HeCoding180/RPiSelectaShield/Hardware/Selecta Pi Shield V1_1.brd

## EAGLE design Hardware/Selecta Pi Shield V1_1.brd (2022-07-05)

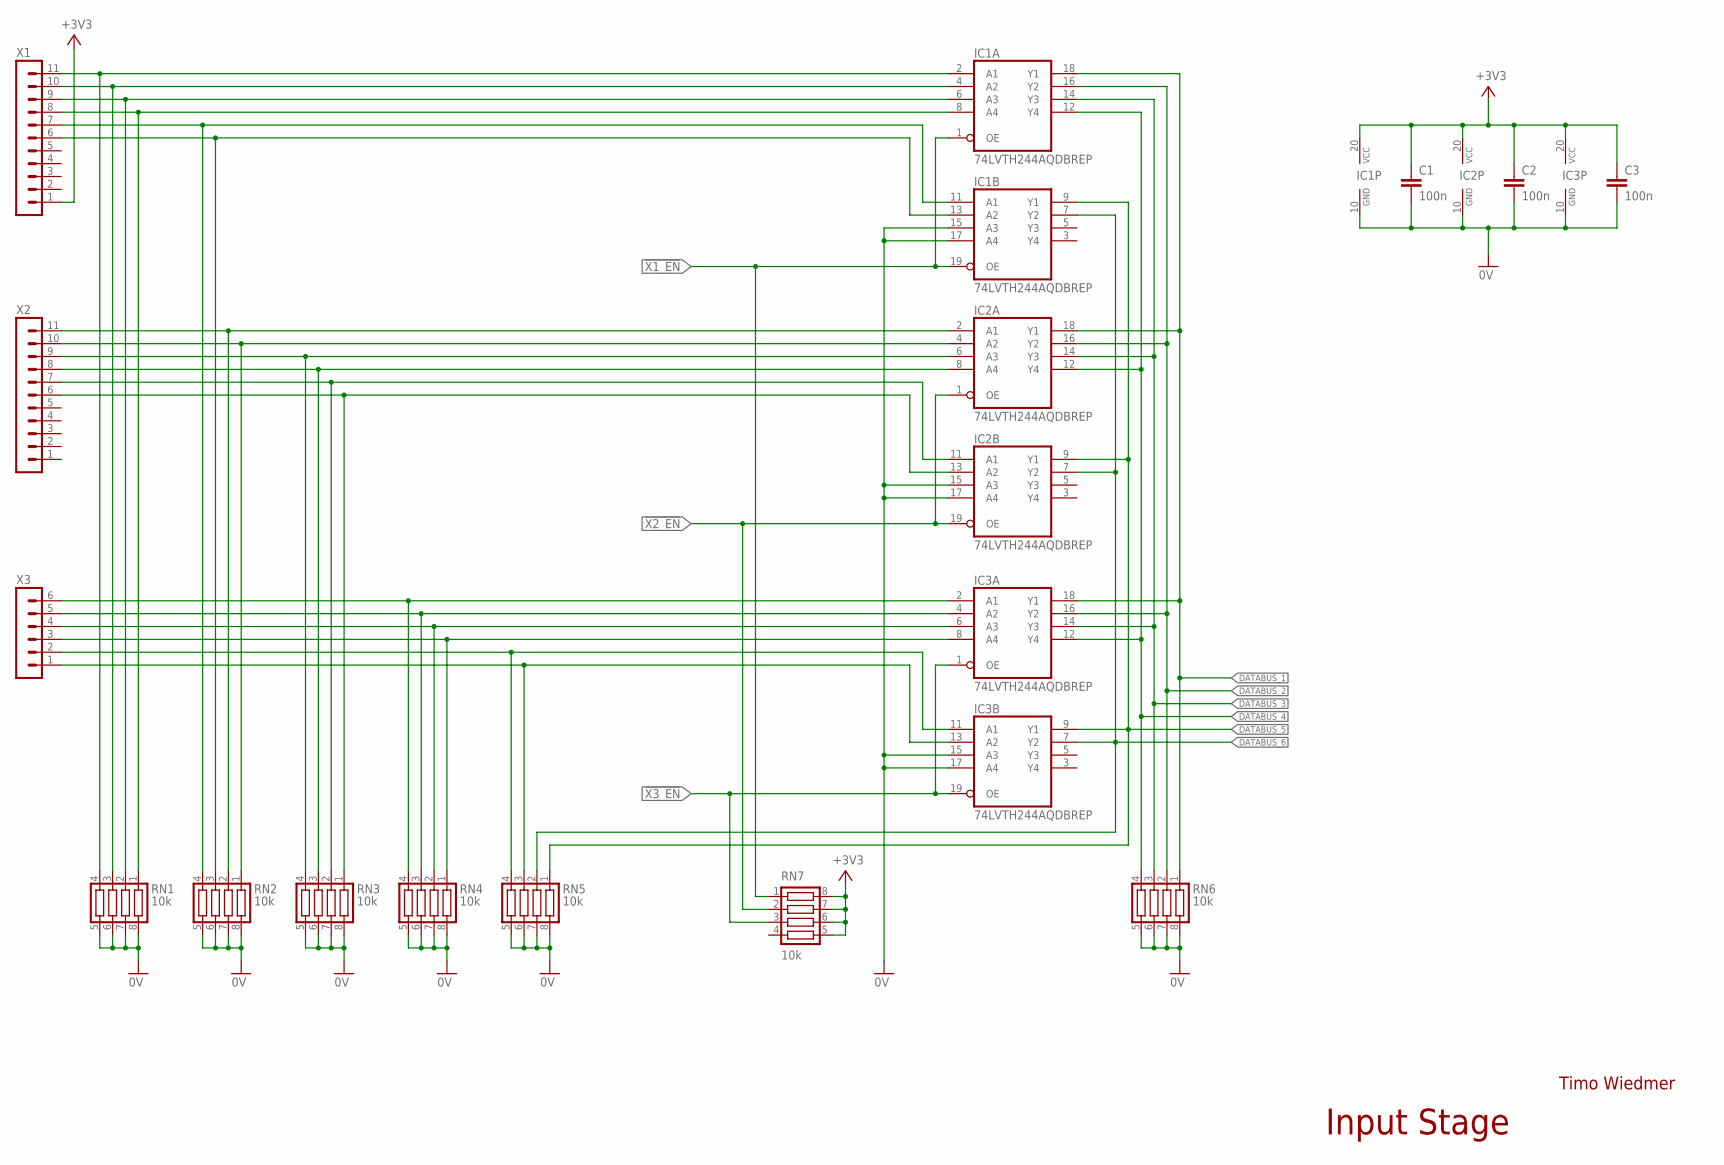
[picture p2: schematic Selecta Pi Shield V1_1.sch, sheet 1]

Parts:
C1, C2, C3: 100n; C0603
IC1, IC2, IC3: 74LVTH244AQDBREP; SSOP20
RN1, RN2, RN3, RN4, RN5, RN6, RN7: 10k; CTS742C083
X1, X2: MA11-1
X3: MA06-1

Connections:
0V: C1.2, C2.2, C3.2, IC1.10 (GND), IC1.15 (A3), IC1.17 (A4), IC2.10 (GND), IC2.15 (A3), IC2.17 (A4), IC3.10 (GND), IC3.15 (A3), IC3.17 (A4), RN1.5, RN1.6, RN1.7, RN1.8, RN2.5, RN2.6, RN2.7, RN2.8, RN3.5, RN3.6, RN3.7, RN3.8, RN4.5, RN4.6, RN4.7, RN4.8, RN5.5, RN5.6, RN5.7, RN5.8, RN6.5, RN6.6, RN6.7, RN6.8; also elsewhere on the board
!X1_EN: IC1.1 (OE), IC1.19 (OE), RN7.1; also elsewhere on the board
!X2_EN: IC2.1 (OE), IC2.19 (OE), RN7.2; also elsewhere on the board
!X3_EN: IC3.1 (OE), IC3.19 (OE), RN7.3; also elsewhere on the board
+3V3: C1.1, C2.1, C3.1, IC1.20 (VCC), IC2.20 (VCC), IC3.20 (VCC), RN7.5, RN7.6, RN7.7, RN7.8, X1.1; also elsewhere on the board
B_SELECT1: IC3.2 (A1), RN4.4, X3.6
B_SELECT2: IC3.4 (A2), RN4.3, X3.5
B_SELECT3: IC3.6 (A3), RN4.2, X3.4
B_SELECT4: IC3.8 (A4), RN4.1, X3.3
B_SELECT5: IC3.11 (A1), RN5.4, X3.2
B_SELECT6: IC3.13 (A2), RN5.3, X3.1
DATABUS_1: IC1.18 (Y1), IC2.18 (Y1), IC3.18 (Y1), RN6.1; also elsewhere on the board
DATABUS_2: IC1.16 (Y2), IC2.16 (Y2), IC3.16 (Y2), RN6.2; also elsewhere on the board
DATABUS_3: IC1.14 (Y3), IC2.14 (Y3), IC3.14 (Y3), RN6.3; also elsewhere on the board
DATABUS_4: IC1.12 (Y4), IC2.12 (Y4), IC3.12 (Y4), RN6.4; also elsewhere on the board
DATABUS_5: IC1.9 (Y1), IC2.9 (Y1), IC3.9 (Y1), RN5.1; also elsewhere on the board
DATABUS_6: IC1.7 (Y2), IC2.7 (Y2), IC3.7 (Y2), RN5.2; also elsewhere on the board
unnamed: IC1.2 (A1), RN1.4, X1.11
unnamed: IC1.4 (A2), RN1.3, X1.10
unnamed: IC1.6 (A3), RN1.2, X1.9
unnamed: IC1.8 (A4), RN1.1, X1.8
unnamed: IC2.2 (A1), RN2.2, X2.11
unnamed: IC2.4 (A2), RN2.1, X2.10
unnamed: IC2.6 (A3), RN3.4, X2.9
unnamed: IC2.8 (A4), RN3.3, X2.8
unnamed: IC1.11 (A1), RN2.4, X1.7
unnamed: IC1.13 (A2), RN2.3, X1.6
unnamed: IC2.11 (A1), RN3.2, X2.7
unnamed: IC2.13 (A2), RN3.1, X2.6

Notes on the sheet:
Timo Wiedmer
Input Stage

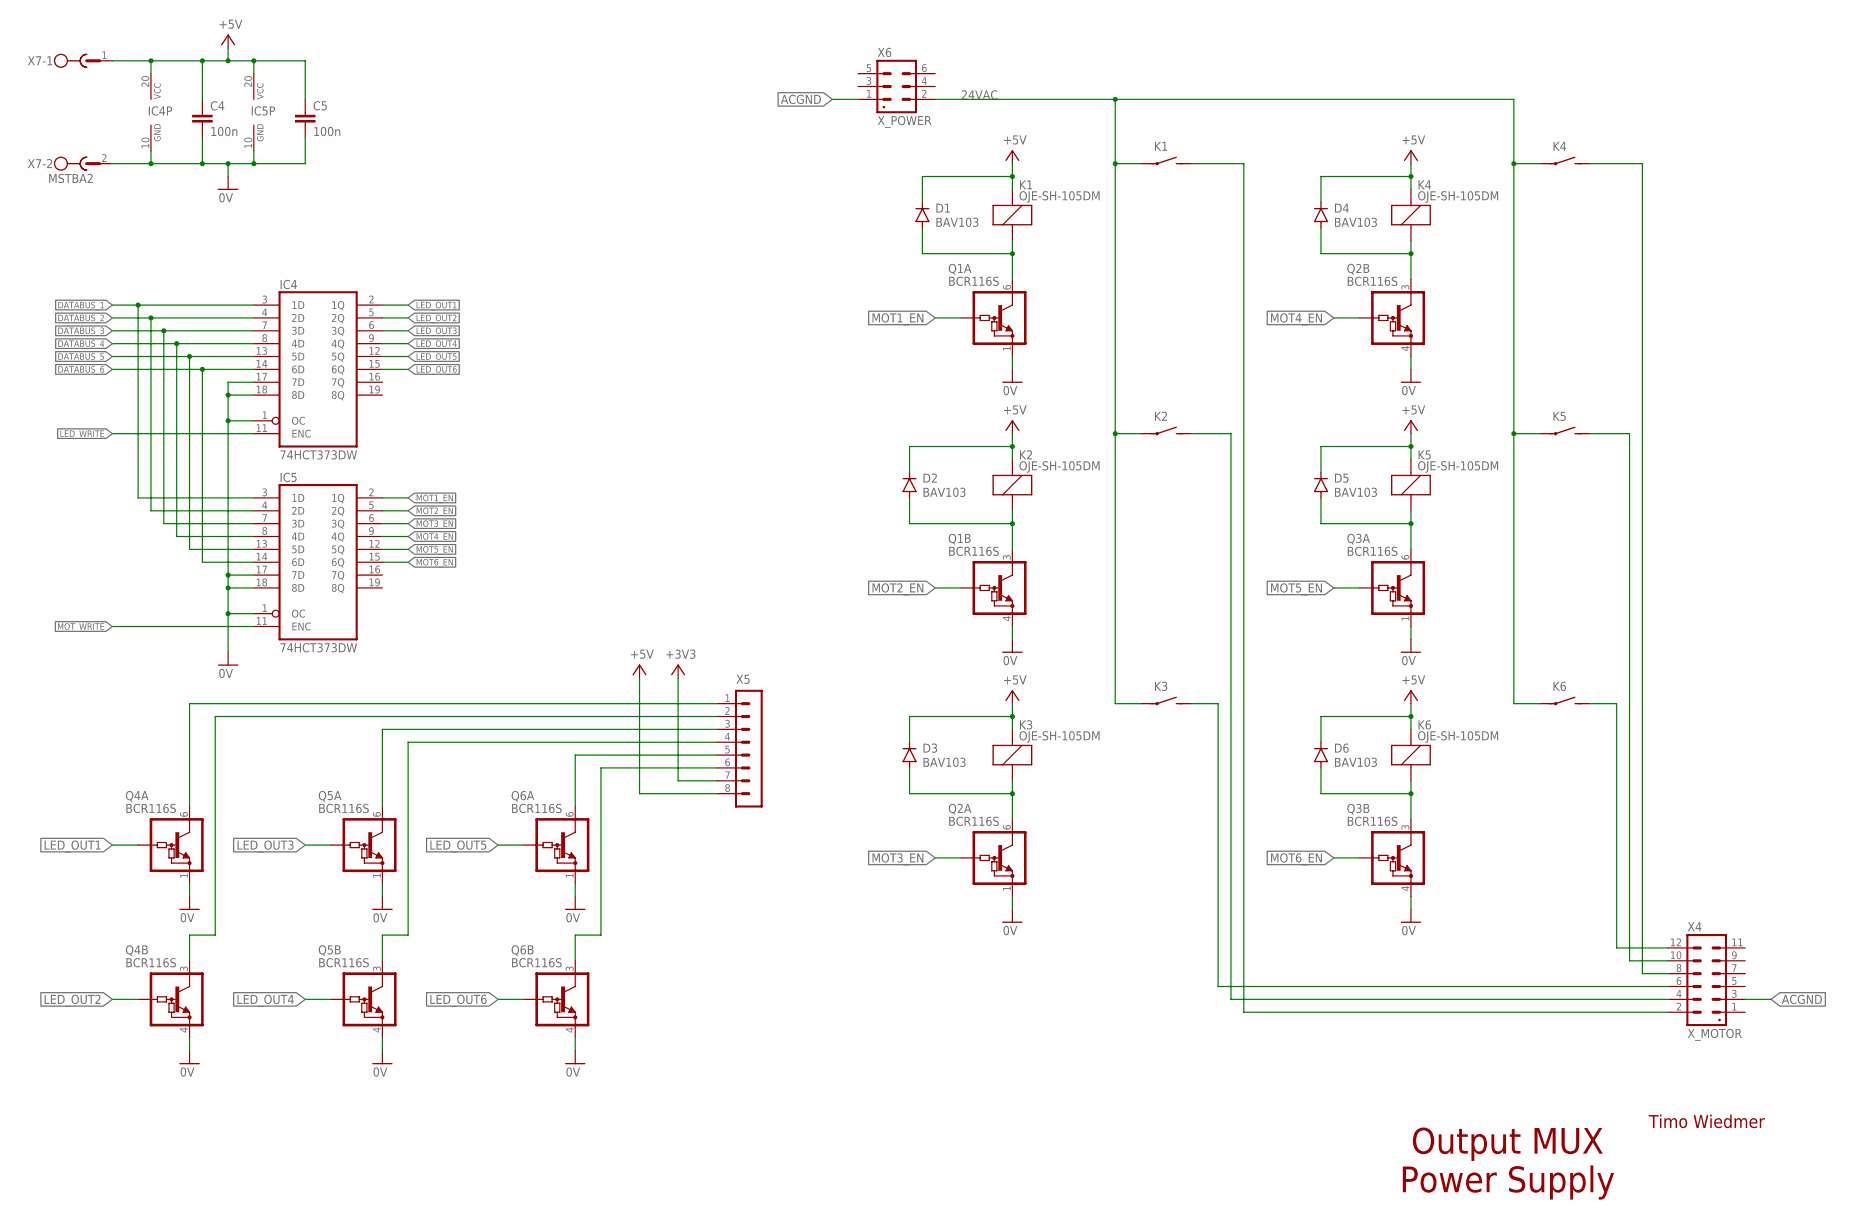
[picture p3: schematic Selecta Pi Shield V1_1.sch, sheet 2]

Parts:
C4, C5: 100n; C0603
D1, D2, D3, D4, D5, D6: BAV103; SOD-123_MINI-SMA
IC4, IC5: 74HCT373DW; SO20W
K1, K2, K3, K4, K5, K6: OJE-SH-105DM
Q1, Q2, Q3, Q4, Q5, Q6: BCR116S; SOT363
X4: X_MOTOR; 12P_MINI_FIT
X5: MA08-1
X6: X_POWER; 6P_MINI_FIT
X7: MSTBA2

Connections:
0V: C4.2, C5.2, IC4.1 (OC), IC4.10 (GND), IC4.17 (7D), IC4.18 (8D), IC5.1 (OC), IC5.10 (GND), IC5.17 (7D), IC5.18 (8D), Q1.1 (E), Q1.4 (E), Q2.1 (E), Q2.4 (E), Q3.1 (E), Q3.4 (E), Q4.1 (E), Q4.4 (E), Q5.1 (E), Q5.4 (E), Q6.1 (E), Q6.4 (E), X7.2; also elsewhere on the board
24VAC: K1.COM, K2.COM, K3.COM, K4.COM, K5.COM, K6.COM, X6.2
24VAC_MOT1: K1.NO, X4.2
24VAC_MOT2: K2.NO, X4.4
24VAC_MOT3: K3.NO, X4.6
24VAC_MOT4: K4.NO, X4.8
24VAC_MOT5: K5.NO, X4.10
24VAC_MOT6: K6.NO, X4.12
+3V3: X5.7; also elsewhere on the board
+5V: C4.1, C5.1, D1.C, D2.C, D3.C, D4.C, D5.C, D6.C, IC4.20 (VCC), IC5.20 (VCC), K1.COILA (1), K2.COILA (1), K3.COILA (1), K4.COILA (1), K5.COILA (1), K6.COILA (1), X5.8, X7.1; also elsewhere on the board
ACGND: X4.3, X6.1
DATABUS_1: IC4.3 (1D), IC5.3 (1D); also elsewhere on the board
DATABUS_2: IC4.4 (2D), IC5.4 (2D); also elsewhere on the board
DATABUS_3: IC4.7 (3D), IC5.7 (3D); also elsewhere on the board
DATABUS_4: IC4.8 (4D), IC5.8 (4D); also elsewhere on the board
DATABUS_5: IC4.13 (5D), IC5.13 (5D); also elsewhere on the board
DATABUS_6: IC4.14 (6D), IC5.14 (6D); also elsewhere on the board
LED1: Q4.6 (C), X5.1
LED2: Q4.3 (C), X5.2
LED3: Q5.6 (C), X5.3
LED4: Q5.3 (C), X5.4
LED5: Q6.6 (C), X5.5
LED6: Q6.3 (C), X5.6
LED_OUT1: IC4.2 (1Q), Q4.2 (B)
LED_OUT2: IC4.5 (2Q), Q4.5 (B)
LED_OUT3: IC4.6 (3Q), Q5.2 (B)
LED_OUT4: IC4.9 (4Q), Q5.5 (B)
LED_OUT5: IC4.12 (5Q), Q6.2 (B)
LED_OUT6: IC4.15 (6Q), Q6.5 (B)
LED_WRITE: IC4.11 (ENC); also elsewhere on the board
MOT1_EN: IC5.2 (1Q), Q1.2 (B)
MOT2_EN: IC5.5 (2Q), Q1.5 (B)
MOT3_EN: IC5.6 (3Q), Q2.2 (B)
MOT4_EN: IC5.9 (4Q), Q2.5 (B)
MOT5_EN: IC5.12 (5Q), Q3.2 (B)
MOT6_EN: IC5.15 (6Q), Q3.5 (B)
MOT_WRITE: IC5.11 (ENC); also elsewhere on the board
unnamed: D3.A, K3.COILB (2), Q2.6 (C)
unnamed: D6.A, K6.COILB (2), Q3.3 (C)
unnamed: D5.A, K5.COILB (2), Q3.6 (C)
unnamed: D2.A, K2.COILB (2), Q1.3 (C)
unnamed: D1.A, K1.COILB (2), Q1.6 (C)
unnamed: D4.A, K4.COILB (2), Q2.3 (C)

Notes on the sheet:
Timo Wiedmer
Output MUX Power Supply

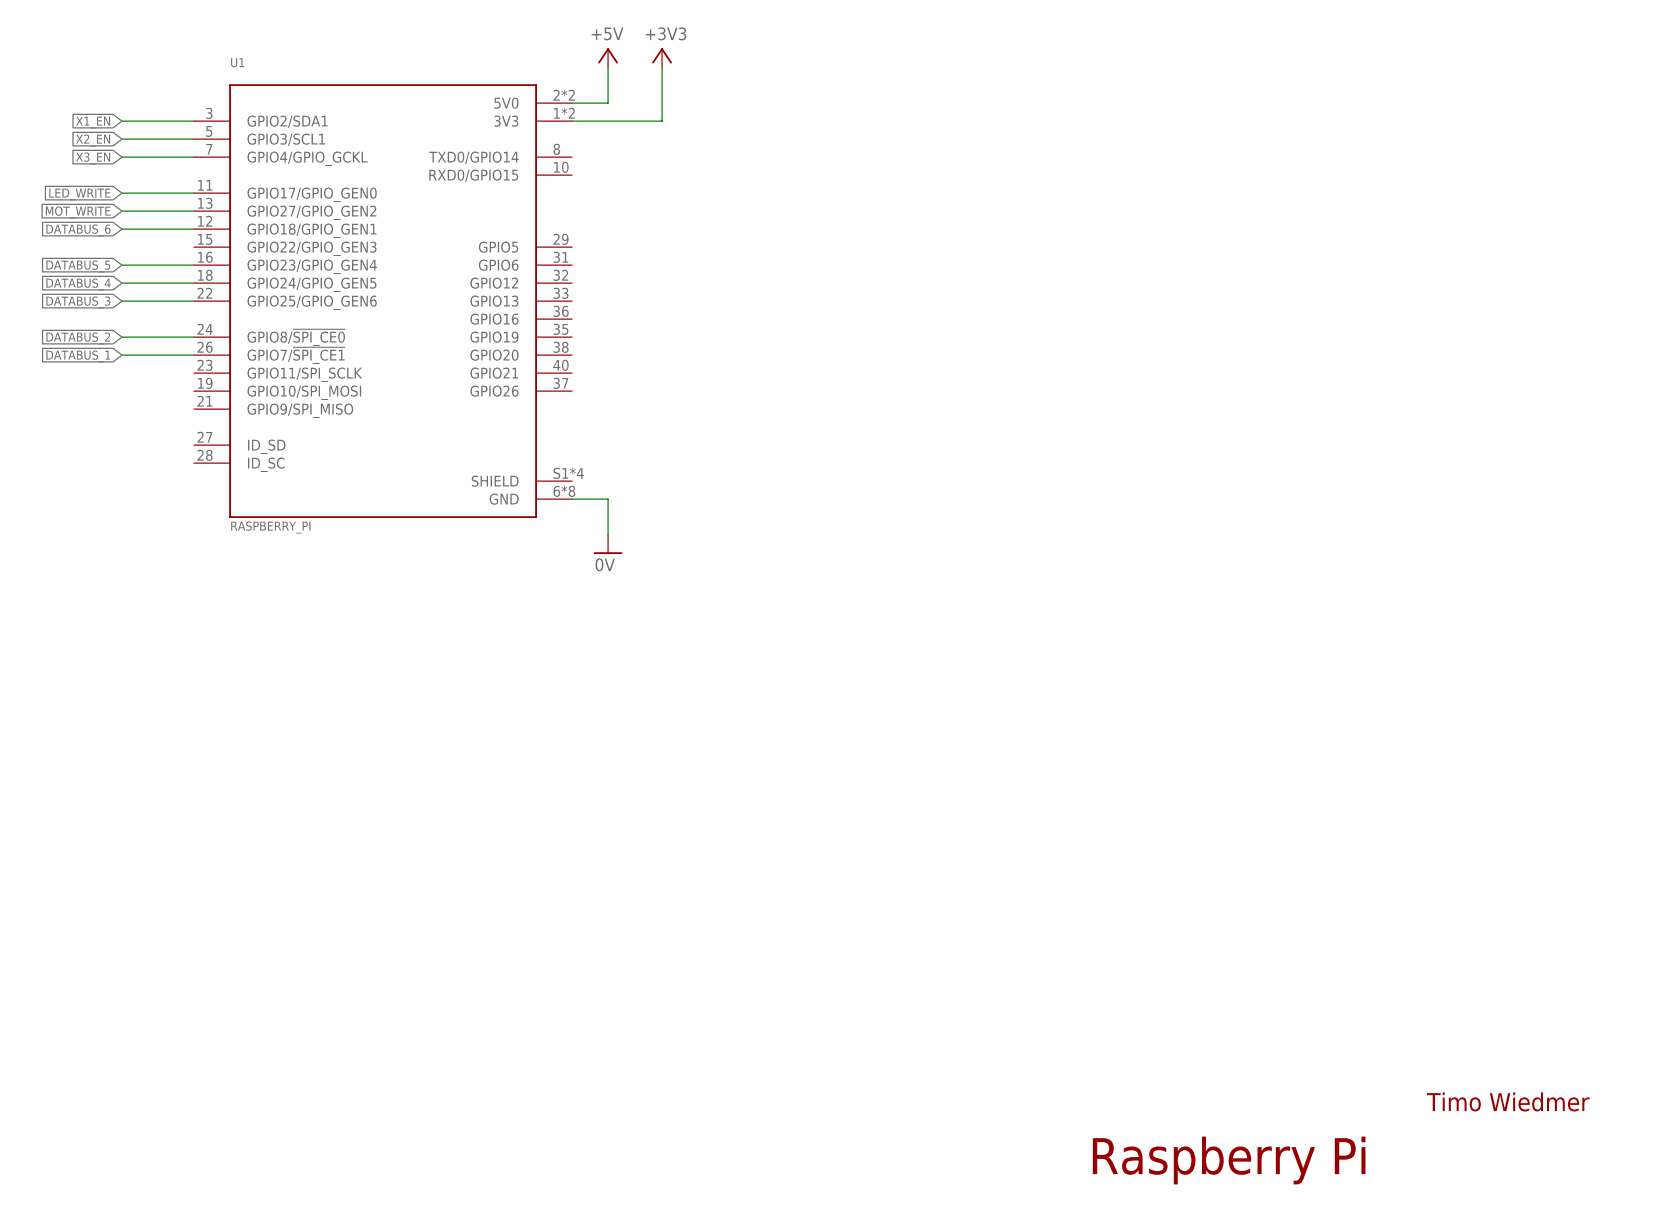
[picture p4: schematic Selecta Pi Shield V1_1.sch, sheet 3]

Parts:
U1: RASPBERRY_PI

Connections:
0V: U1.6 (GND), U1.9 (GND), U1.14 (GND), U1.20 (GND), U1.25 (GND), U1.30 (GND), U1.34 (GND), U1.39 (GND); also elsewhere on the board
!X1_EN: U1.3 (GPIO2/SDA1); also elsewhere on the board
!X2_EN: U1.5 (GPIO3/SCL1); also elsewhere on the board
!X3_EN: U1.7 (GPIO4/GPIO_GCKL); also elsewhere on the board
+3V3: U1.1 (3V3), U1.17 (3V3); also elsewhere on the board
+5V: U1.2 (5V0), U1.4 (5V0); also elsewhere on the board
DATABUS_1: U1.26 (GPIO7/!SPI_CE1!); also elsewhere on the board
DATABUS_2: U1.24 (GPIO8/!SPI_CE0!); also elsewhere on the board
DATABUS_3: U1.22 (GPIO25/GPIO_GEN6); also elsewhere on the board
DATABUS_4: U1.18 (GPIO24/GPIO_GEN5); also elsewhere on the board
DATABUS_5: U1.16 (GPIO23/GPIO_GEN4); also elsewhere on the board
DATABUS_6: U1.12 (GPIO18/GPIO_GEN1); also elsewhere on the board
LED_WRITE: U1.11 (GPIO17/GPIO_GEN0); also elsewhere on the board
MOT_WRITE: U1.13 (GPIO27/GPIO_GEN2); also elsewhere on the board
SHIELD: U1.S1 (SHIELD), U1.S2 (SHIELD), U1.S3 (SHIELD), U1.S4 (SHIELD)

Notes on the sheet:
Timo Wiedmer
Raspberry Pi

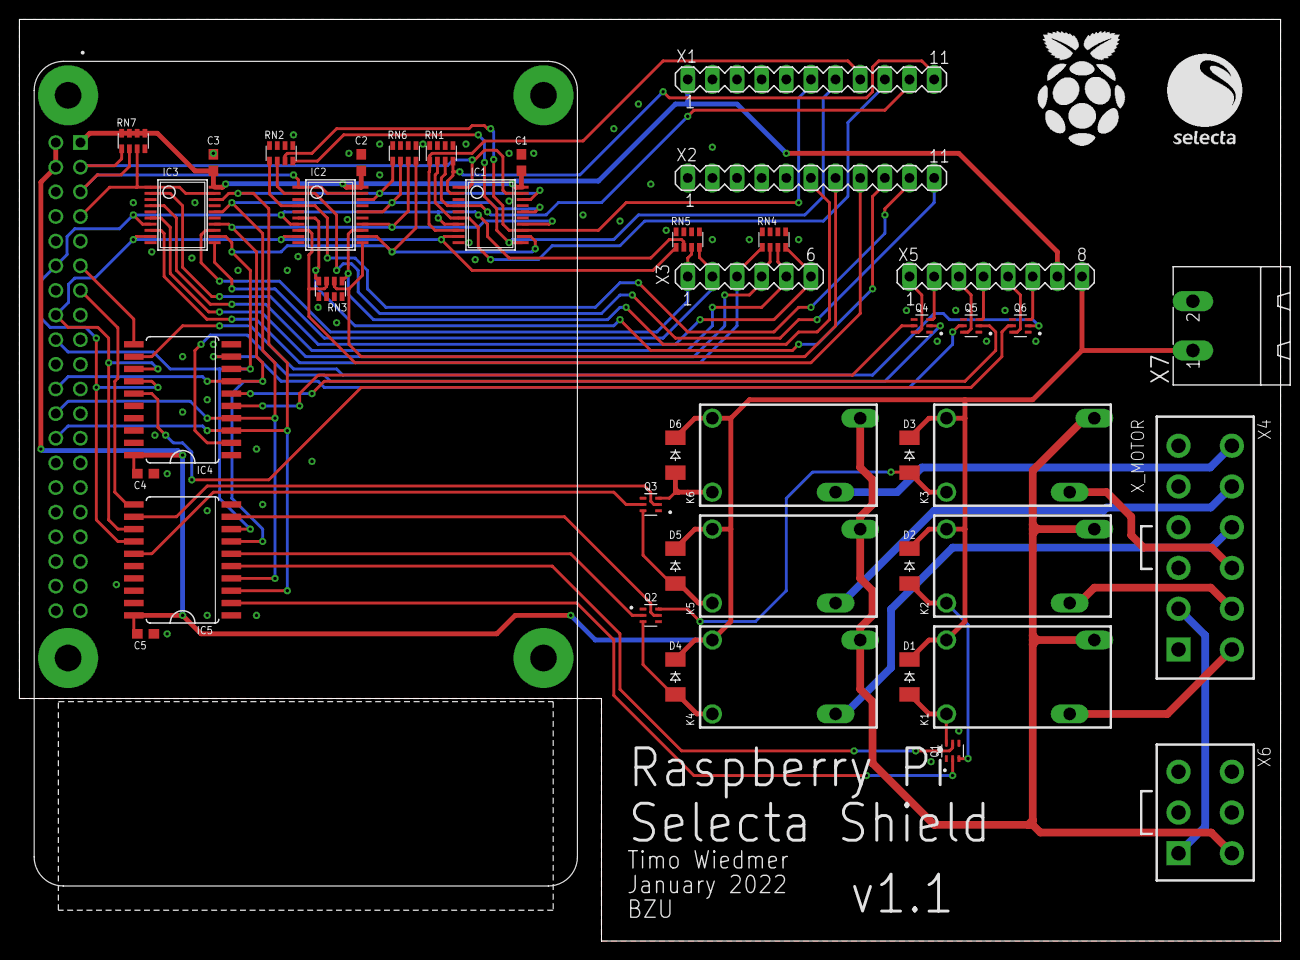
[picture p5: board Selecta Pi Shield V1_1.brd from above]

Board: 2 copper layers, 130.0 x 95.0 mm, 45 parts (0 on the bottom side), 65 nets.

Other parts of the board:
U$1: RASPBERRY_LOGO
U$2: SELECTA_LOGO
