HeCoding180/RPiSelectaShield/(commit log)

2022-01-24 small issues fixed, simplifications added
    readData() and some other small issues fixed.
    replaced all self.ON with GPIO.HIGH, replaced all self.OFF with GPIO.LOW
    [SelectaShieldLibrary.py]
2022-01-24 PCB Design Files V1.0 were added
    [Selecta Pi Shield V1.brd, Selecta Pi Shield V1.sch]
2022-03-21 Current Limitation Added
    Current limitation added by limiting the amount of motors used at once to 1 motor.
2022-03-21 motor limit console notification added
2022-07-05 Version: v1.1 Push
    [Selecta Pi Shield V1.brd, Selecta Pi Shield V1.sch, Selecta Pi Shield V1_1.brd, Selecta Pi Shield V1_1.sch]
